SidBroGG/manipulator3/assets/meshes/RoboticHandMain-link_1.stl

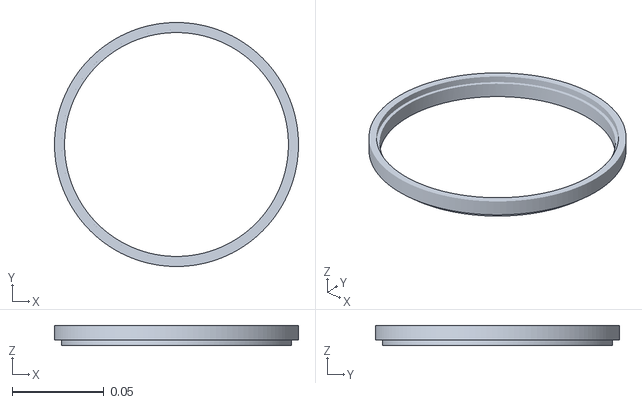
[picture p1: CAD file, 2026-11-08]
assets/meshes/RoboticHandMain-link_1.stl
0.133 x 0.133 x 0.011
