SidBroGG/manipulator3/assets/meshes/RoboticHandMain-gear_lower.stl

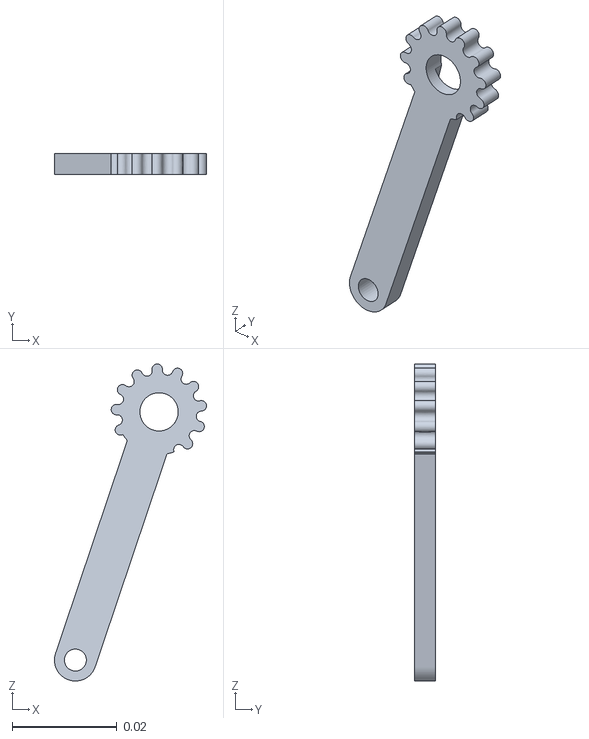
[picture p2: CAD file, 2026-11-08]
assets/meshes/RoboticHandMain-gear_lower.stl
0.029 x 0.004 x 0.0605
