SidBroGG/manipulator3/assets/meshes/RoboticHandMain-servo_lower.stl

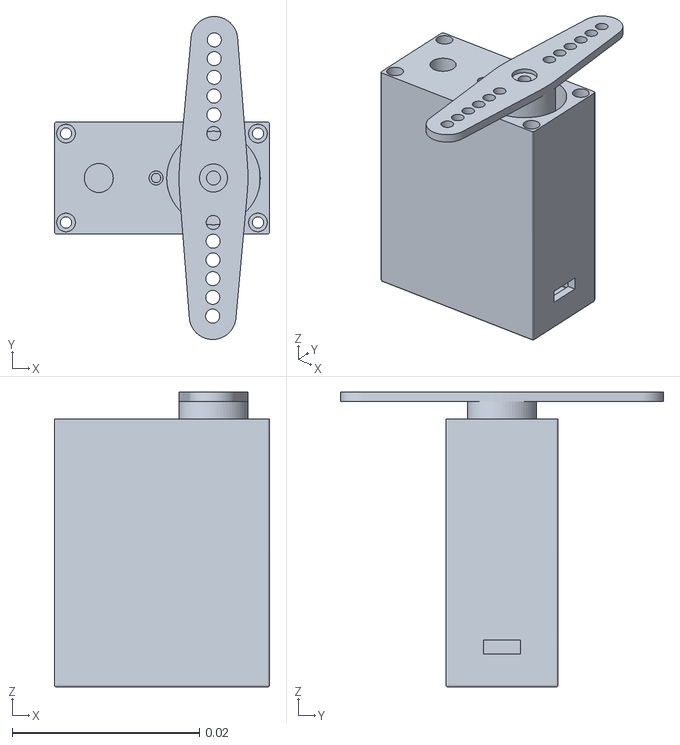
[picture p3: CAD file, 2026-11-08]
assets/meshes/RoboticHandMain-servo_lower.stl
0.023 x 0.0345 x 0.0315
