SidBroGG/manipulator3/assets/meshes/RoboticHandMain-mg996R_v2_step__1__2.stl

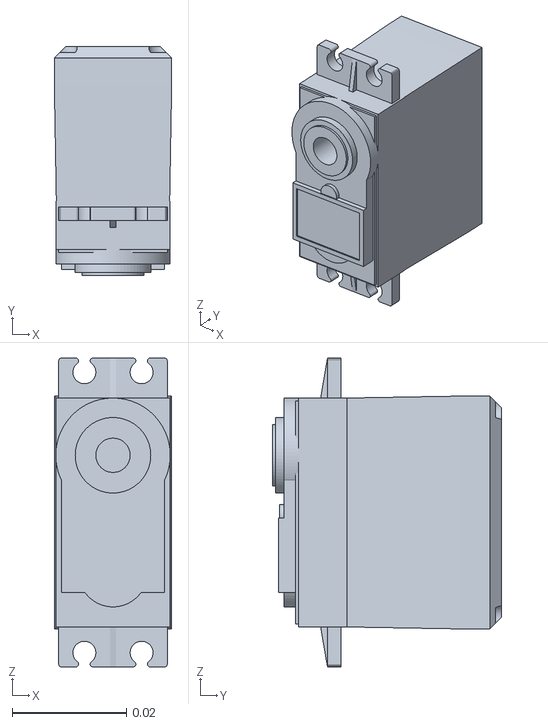
[picture p4: CAD file, 2026-11-08]
assets/meshes/RoboticHandMain-mg996R_v2_step__1__2.stl
0.0205 x 0.04 x 0.054
