SidBroGG/manipulator3/assets/meshes/RoboticHandMain-mg996_arm_6pad_step__1__2.stl

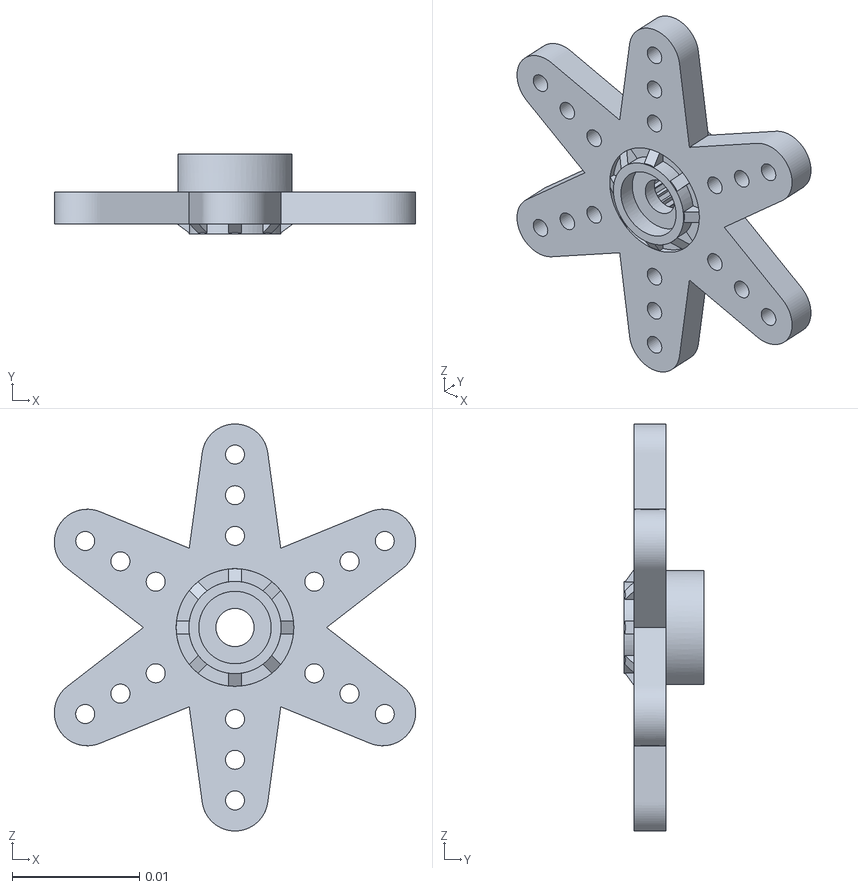
[picture p5: CAD file, 2026-11-08]
assets/meshes/RoboticHandMain-mg996_arm_6pad_step__1__2.stl
0.0284 x 0.0063 x 0.032
