SidBroGG/manipulator3/assets/meshes/RoboticHandMain-claw_base-collision.stl

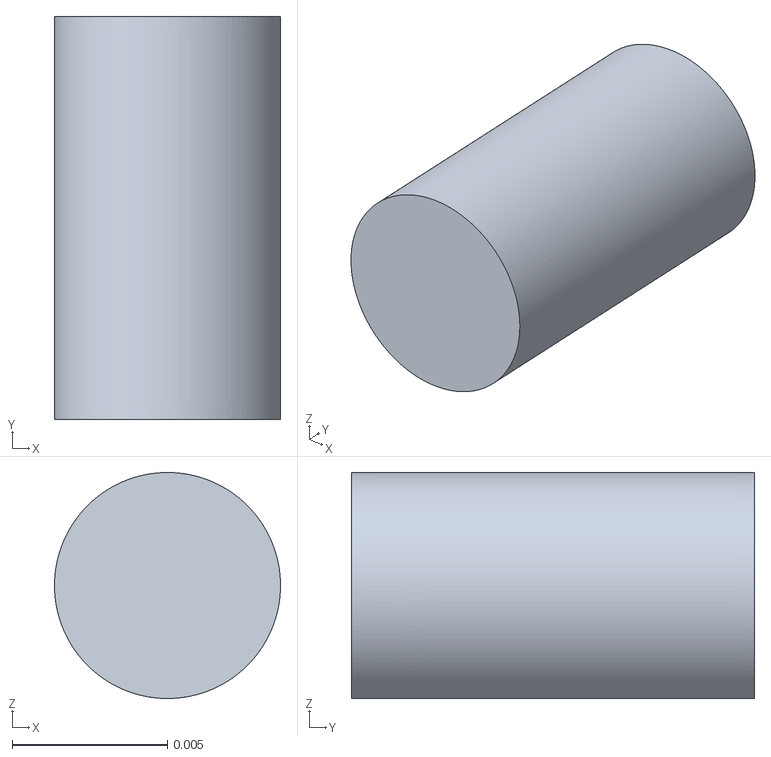
[picture p6: CAD file, 2026-11-08]
assets/meshes/RoboticHandMain-claw_base-collision.stl
0.00729 x 0.013 x 0.00729
