SidBroGG/manipulator3/assets/meshes/RoboticHandMain-wrist_mount.stl

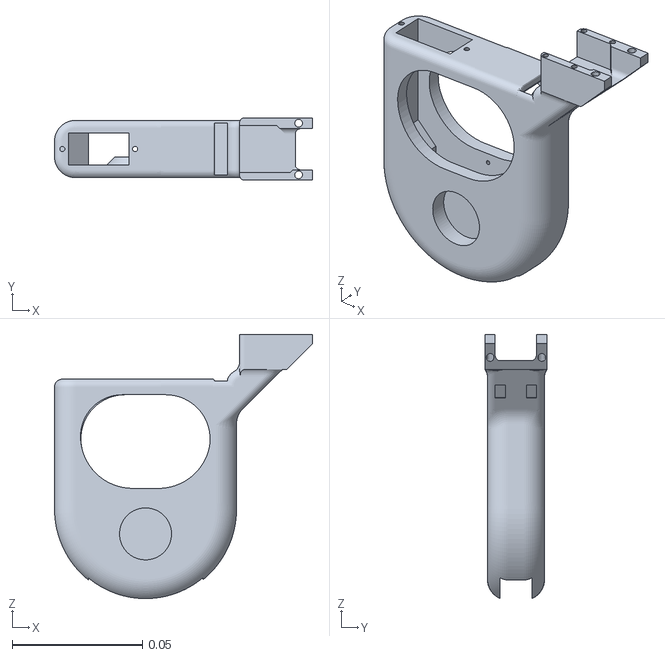
[picture p7: CAD file, 2026-11-08]
assets/meshes/RoboticHandMain-wrist_mount.stl
0.0992 x 0.024 x 0.102
