SidBroGG/manipulator3/assets/meshes/RoboticHandMain-____________.stl

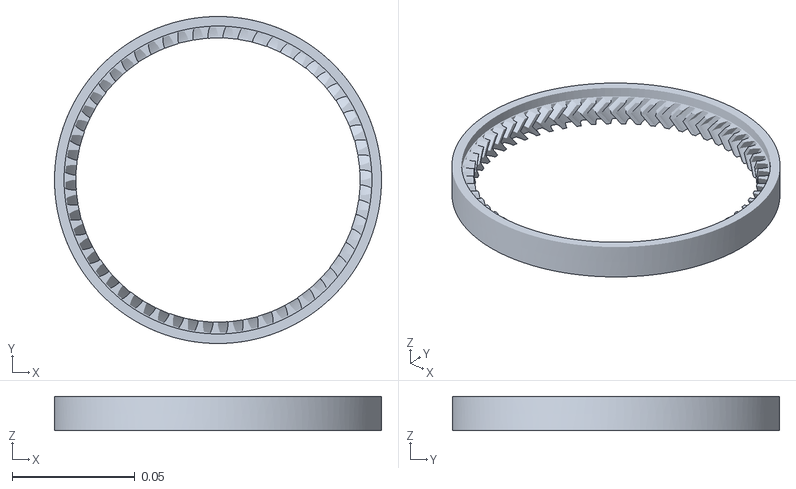
[picture p8: CAD file, 2026-11-08]
assets/meshes/RoboticHandMain-____________.stl
0.133 x 0.133 x 0.014
