SidBroGG/manipulator3/assets/meshes/RoboticHandMain-base_link.stl

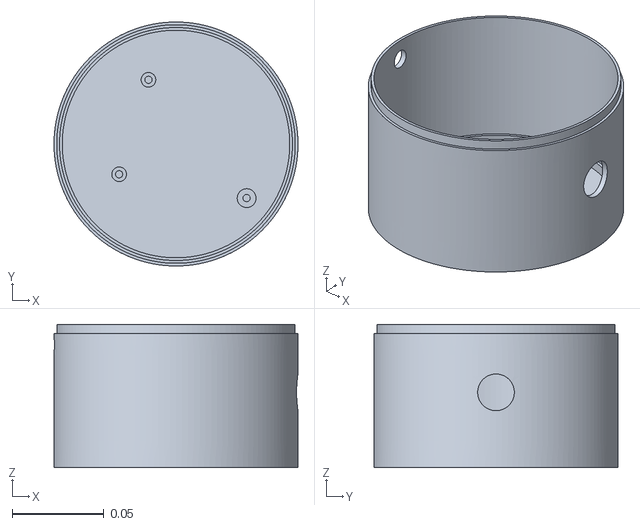
[picture p9: CAD file, 2026-11-08]
assets/meshes/RoboticHandMain-base_link.stl
0.133 x 0.133 x 0.078
