SidBroGG/manipulator3/assets/meshes/RoboticHandMain-link_3.stl

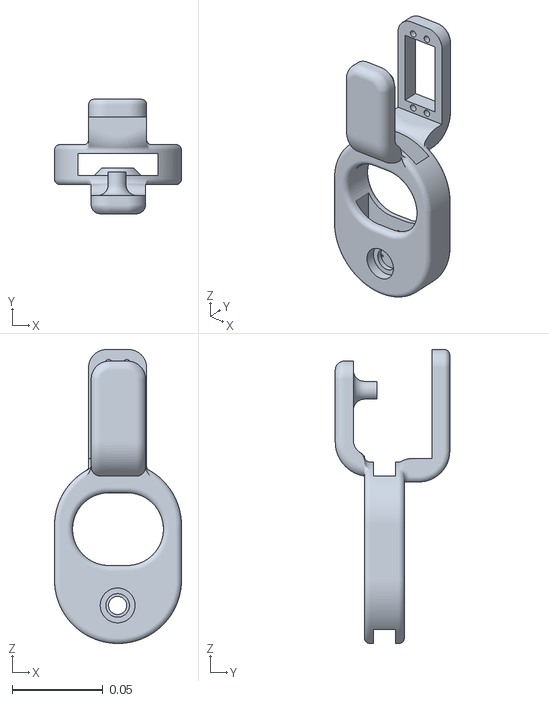
[picture p10: CAD file, 2026-11-08]
assets/meshes/RoboticHandMain-link_3.stl
0.07 x 0.0631 x 0.162
