SidBroGG/manipulator3/assets/meshes/RoboticHandMain-RPi_cam_Rev_1_3_SLDPRT__1_.stl

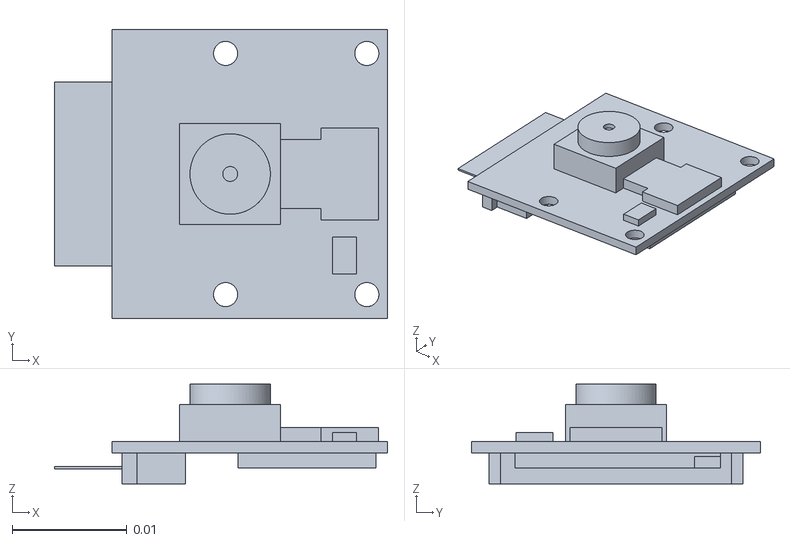
[picture p11: CAD file, 2026-11-08]
assets/meshes/RoboticHandMain-RPi_cam_Rev_1_3_SLDPRT__1_.stl
0.029 x 0.0252 x 0.0087
