SidBroGG/manipulator3/assets/meshes/RoboticHandMain-connector_lower.stl

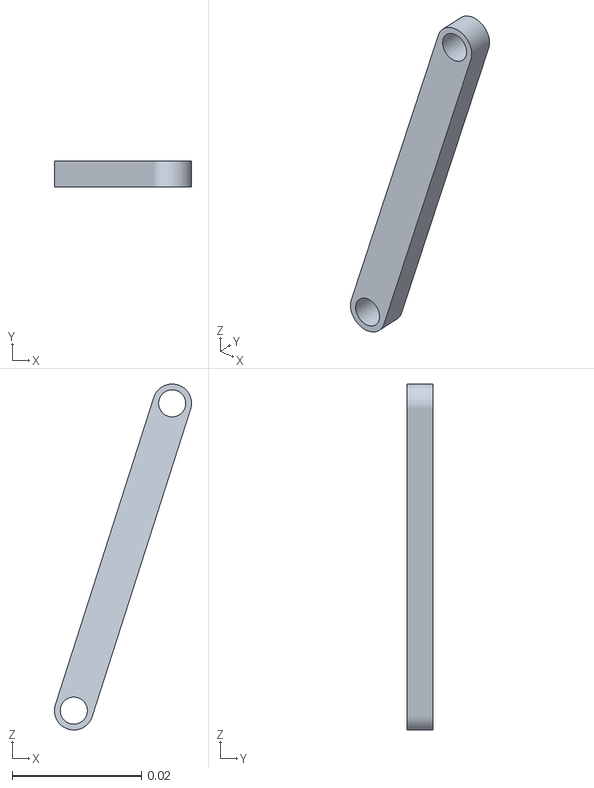
[picture p12: CAD file, 2026-11-08]
assets/meshes/RoboticHandMain-connector_lower.stl
0.0212 x 0.004 x 0.0536
