SidBroGG/manipulator3/assets/meshes/RoboticHandMain-connector_upper.stl

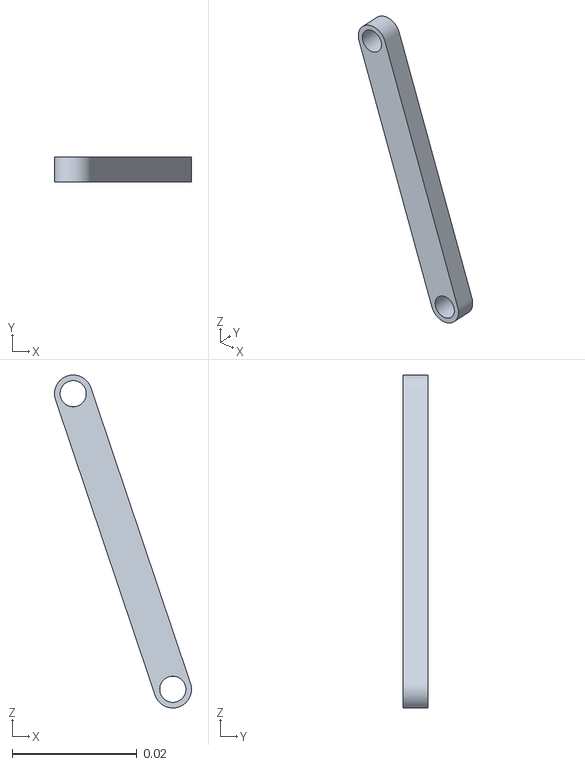
[picture p13: CAD file, 2026-11-08]
assets/meshes/RoboticHandMain-connector_upper.stl
0.022 x 0.004 x 0.0534
