SidBroGG/manipulator3/assets/meshes/RoboticHandMain-link_2.stl

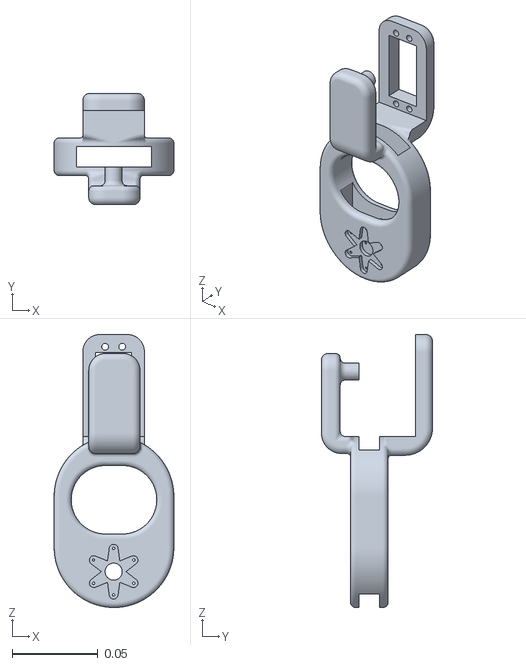
[picture p14: CAD file, 2026-11-08]
assets/meshes/RoboticHandMain-link_2.stl
0.07 x 0.065 x 0.16
