SidBroGG/manipulator3/assets/meshes/RoboticHandMain-claw_lower.stl

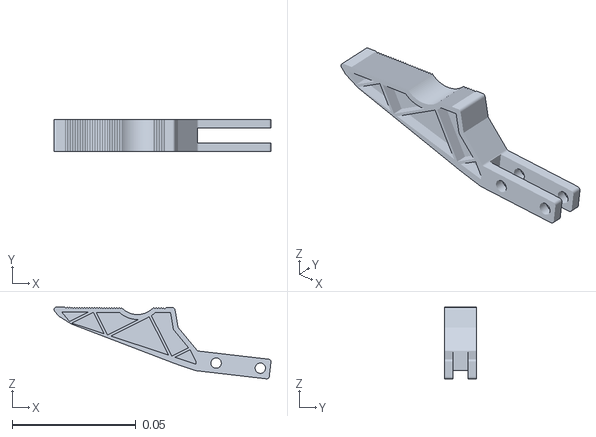
[picture p15: CAD file, 2026-11-08]
assets/meshes/RoboticHandMain-claw_lower.stl
0.0878 x 0.0129 x 0.029
