SidBroGG/manipulator3/assets/meshes/RoboticHandMain-claw_upper.stl

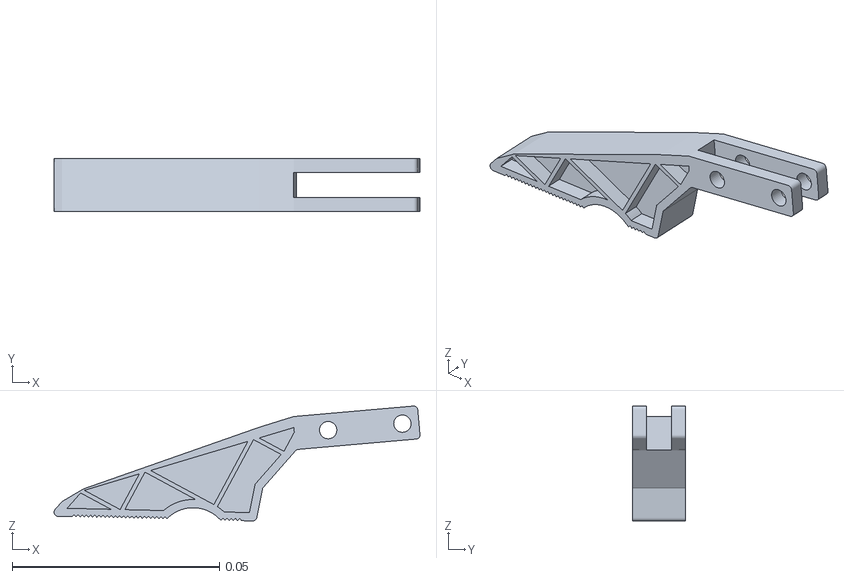
[picture p16: CAD file, 2026-11-08]
assets/meshes/RoboticHandMain-claw_upper.stl
0.0884 x 0.0129 x 0.0278
