SidBroGG/manipulator3/assets/meshes/RoboticHandMain-claw_base.stl

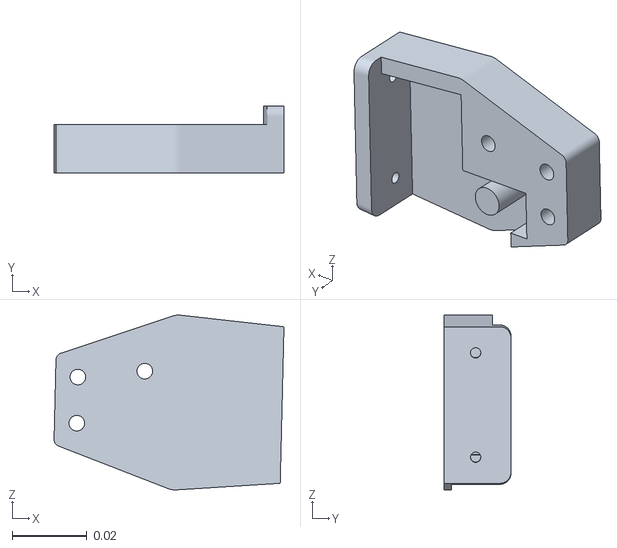
[picture p17: CAD file, 2026-11-08]
assets/meshes/RoboticHandMain-claw_base.stl
0.0617 x 0.018 x 0.0469
