SidBroGG/manipulator3/(list of files, cad)

Other CAD files:
assets/meshes/RoboticHandMain-mg996_arm_6pad_step__2_.stl
assets/meshes/RoboticHandMain-mg996R_v2_step__1_.stl
assets/meshes/RoboticHandMain-gear_upper.stl
assets/meshes/RoboticHandMain-mg996_arm_6pad_step.stl
assets/meshes/RoboticHandMain-mg996R_v2_step.stl
assets/meshes/RoboticHandMain-mg996R_v2_step__2_.stl
assets/meshes/RoboticHandMain-mg996_arm_6pad_step__1_.stl
assets/meshes/RoboticHandMain-_____________.stl
assets/meshes/RoboticHandMain-______________.stl
