SidBroGG/manipulator3/(commit log)

2026-10-15 Initial commit: project architecture, plan, guidelines, and dependencies
    [RobohandForSimBack_x_t_______110.stl, base___________.stl, base__spinningPart.stl, elbow__main.stl, main__gripper1.stl, main__gripper2.stl, main__gripperBase.stl, root.urdf]
2026-10-15 feat(stage-1): sanitize URDF meshes and implement MuJoCo MJCF model with sensors
    [base_spinning.stl, base_stand.stl, elbow.stl, gripper_base.stl, gripper_finger1.stl, gripper_finger2.stl, root.urdf, shoulder.stl]
2026-10-15 refactor: consolidate all models and meshes into assets/ and remove urdf_model/
    [base_spinning.stl, base_stand.stl, elbow.stl, gripper_base.stl, gripper_finger1.stl, gripper_finger2.stl, root.urdf, shoulder.stl]
2026-10-15 Implement Stage 2: simulation tabletop scene and virtual sensor feeds
2026-10-15 fix: elevate manipulator base_link so stand sits flush on table surface
    [test_stage2_simulation.py]
2026-10-15 Rotate base 180 deg and orient gripper approach so camera is on top
2026-10-15 feat(stage-3): Zenoh communication layer and digital twin bridge
2026-10-15 feat(stage4): implement IK kinematics engine, trajectory planner, and safety limits
2026-10-15 refactor(kinematics): remove redundant pose aliases and unify baseline poses in plan
2026-10-15 feat(stage5): implement MediaPipe hand tracking and table ray-plane intersection
2026-10-16 feat(perception): implement Stage 6 object detection (YOLO11n) and visual servoing search
2026-10-16 fix(detector): filter out gripper finger artifacts and non-table classes from YOLO detections
    [detector.py, test_stage6_detector.py]
2026-10-16 fix(servoing): add anti-windup, jitter filter, deadband and lower gain to eliminate hunting oscillations
    [detector_preview.py, servoing.py]
2026-10-16 fix(servoing): prevent gravity droop drift by preserving joint setpoints and lock onto tracked target
    [detector.py, detector_preview.py, servoing.py]
2026-10-16 feat(manipulator): implement Stage 7 ToF-assisted grasping and pick-and-place state machine
    [root.urdf]
2026-10-16 fix(interaction): add OneEuroFilter anti-jitter, AR target markers, and magnetic snap
    [interactive.py, pointing.py]
2026-10-16 fix(pointing): add is_pointing_gesture method to HandTracker
    [interactive.py, pointing.py, test_stage7_statemachine.py]
2026-10-16 fix(simulation): exclude visual hand marker from ToF raycast and bound lift Z
    [grasping.py, model.py, state_machine.py]
2026-10-16 fix(control): accelerate visual align, increase grip force, and add aerial clearance arch
    [grasping.py, servoing.py, state_machine.py]
2026-10-16 fix(servoing): add PD derivative damping and actual_q smoothing to eliminate oscillation
    [interactive.py, servoing.py, state_machine.py]
2026-10-17 Fixed object gripping(object slipping and collision problems)
    [detector.py, grasping.py, interactive.py, servoing.py, simulation.py, state_machine.py, statemachine_preview.py]
2026-10-17 feat(rpi): implement Stage 8 thin client for RPi Zero 2 W with camera, ToF, and servo PWM
2026-10-17 Revert "feat(rpi): implement Stage 8 thin client for RPi Zero 2 W with camera, ToF, and servo PWM"
    This reverts commit b4e500842ff49f3f4032f07b09d12741197efdb6.
2026-10-17 Implement Stage 8: Thin Client for Raspberry Pi Zero 2 W with A4988 stepper, dual shoulder PWM servos, VL53L0X ToF, and OV5647 camera
2026-10-17 Enhance hardware.py with multi-driver VL53L0X support, alias normalization and add rich HUD overlay to rpi_preview
2026-10-17 Add smbus2 & adafruit-circuitpython-vl53l0x to dependencies, use dynamic optional imports in hardware.py
2026-10-23 feat(thin-client): add interactive servo testing and calibration tool for RPi Zero W
2026-10-23 fix(thin-client): decouple numpy and cv2 from base dependencies to use apt system packages
    [hardware.py, protocol.py]
2026-10-23 fix(thin-client): add PWM signal hold duration and lazy pin activation to prevent twitching and brownouts
    [hardware.py, servo_tester.py]
2026-10-23 feat(hardware): add PiGPIOBackend using DMA hardware PWM for jitter-free servo control
    [hardware.py, test_stage8_thin_client.py]
2026-10-23 fix(pigpio): add pin bounds validation to prevent pin 29 permission warnings and allow pin override
    [hardware.py, servo_tester.py]
2026-10-23 fix(pinout): update Shoulder B to BCM 19 (Physical Pin 35)
    [hardware.py, servo_tester.py]
2026-10-24 perf(thin-client): lazy load heavy modules, persist servo state and fix smooth motion
    [hardware.py, protocol.py, servo_test.py, servo_tester.py, test_stage9_servo_tester.py]
2026-11-02 fix(thin-client): make adafruit-circuitpython-vl53l0x optional to prevent sysv-ipc build failure without python3-dev
2026-11-05 fix(hardware): add lgpio tx_servo pulse generation and active backend diagnostics
    [hardware.py, servo_tester.py]
2026-11-05 Fix unstable frequency on Raspberry Pi GPIO pins (DMA auto-launch, pulse deduplication, constant stepper pacing, CPU performance mode)
    [gpio_diagnostics.py, hardware.py, servo_tester.py, test_stage8_thin_client.py, thin_client.py]
2026-11-05 Fix PWM signal amplitude and jitter stability (16mA drive, phase staggering, totem-pole MODE2)
    [gpio_diagnostics.py, hardware.py, test_stage8_thin_client.py]
2026-11-05 Auto-launch pigpiod DMA daemon, safe non-blocking subcommands, eliminate software PWM jitter
    [gpio_diagnostics.py, hardware.py]
2026-11-05 Fix AttributeError 'pi' object has no attribute 'OUTPUT' in gpio_diagnostics
    [gpio_diagnostics.py, test_stage9_servo_tester.py]
2026-11-06 Fix smooth servo mode with minimum-jerk S-curve and monotonic real-time pacing
    [servo_tester.py, test_stage9_servo_tester.py]
2026-11-08 Replace manipulator model with RoboticHandMain CAD export
    [RoboticHandMain-RPi_cam_Rev_1_3_SLDPRT__1_.stl, RoboticHandMain-____________.stl, RoboticHandMain-_____________.stl, RoboticHandMain-______________.stl, RoboticHandMain-base_link.stl, RoboticHandMain-claw_base-collision.stl, RoboticHandMain-claw_base.stl, RoboticHandMain-claw_lower.stl]
